Habanes/BFH_balancing_robot/documentation/balanceBot/hardware/RaspiGPIO_V12.xlsx

Pin | GPIO | Function | Pull |  | i2C Adress
1 |  | 3.3V |  | ADC: | 0x4B | 1001011
2 |  | 5V |  |  | 0x4D | 1001101
3 | GPIO 2 | I2C SDA | up
4 |  | 5V |  | oldIMU: | 0x53 | 1010011
5 | GPIO 3 | I2C SCL | up
6 |  | GND |  | newIMU: | 0x28 | 0101000
7 | GPIO 4 | NC | up
8 | GPIO 14 | NC | down
9 |  | GND
10 | GPIO 15 | NC | down
11 | GPIO 17 | M1_Other | down
12 | GPIO 18 | M2_Other | down
13 | GPIO 27 | NC | down
14 |  | GND
15 | GPIO 22 | NC | down
16 | GPIO 23 | M1_Dir | down
17 |  | 3.3V
18 | GPIO 24 | M2_Dir | down
19 | GPIO 10 | Encoder2_B | down
20 |  | GND
21 | GPIO 9 | Encoder2_A | down
22 | GPIO 25 | NC | down
23 | GPIO 11 | Encoder2_I | down
24 | GPIO 8 | Reset_IMU | up
25 |  | GND
26 | GPIO 7 | Int1 | up
27 | ID_SD | NC
28 | ID_SC | NC
29 | GPIO 5 | NC | up
30 |  | GND
31 | GPIO 6 | NC | up
32 | GPIO 12 | M2_PWM | down
33 | GPIO 13 | M1_PWM | down
34 |  | GND
35 | GPIO 19 | Encoder1_A | down
36 | GPIO 16 | NC | down
37 | GPIO 26 | NC | down
38 | GPIO 20 | Encoder1_B | down
39 |  | GND
40 | GPIO 21 | Encoder1_I | down
