Habanes/BFH_balancing_robot/documentation/balanceBot/hardware/BalanceRobotBOM_V12.xlsx

Comment | Description | Designator | Footprint | LibRef | Value | Quantity per board | price/1 | price total | ordering from | order nr | link
DRV8231ADDAR | Motor Drives 33V H bridge motor driver with current regulation and current sense feedback | B1, B3 | SOIC127P600X170-9M | DRV8231ADDAR |  | 2 | 0.8 | 1.6 | mouser | 595-DRV8231ADDAR | https://www.mouser.ch/ProductDetail/Texas-Instruments/DRV8231ADDAR?qs=Li%252BoUPsLEnsv4Ur6m37LNQ%3D%3D
MCP3021A3T-E_OT | Analog to Digital Converters - ADC 10-bit ADC I2C Single Channel | B2 | SOT95P280X145-5M | MCP3021A3T-E_OT |  | 1 | 1.22 | 1.22 | mouser | 579-MCP3021A3T-E/OT | https://www.mouser.ch/ProductDetail/Microchip-Technology/MCP3021A3T-E-OT?qs=uHi2%2FQoPa5Cra0xx31l%252Buw%3D%3D
MCP3021A3T-E_OT | ANDERE I2C ADRESSE!!!! | B4 |  |  |  | 1 | 1.22 | 1.22 | mouser | 579-MCP3021A5T-E/OT | https://www.mouser.ch/ProductDetail/Microchip-Technology-Atmel/MCP3021A5T-E-OT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
S-1011A70-M6T1U4 | Supervisory Circuits VOLTAGE DETECTOR | B5 | SOT95P275X135-6N | S-1011A70-M6T1U4 |  | 1 | 1.28 | 1.28 | mouser | 628-S-1011A70-M6T1U4 | https://www.mouser.ch/ProductDetail/ABLIC/S-1011A70-M6T1U4
AP1501-50K5G-13 | IC REG BUCK 5V 3A TO263-5 | B6 | AP150150K5G13 | AP1501-50K5G-13 |  | 1 | 1.6 | 1.6 | mouser | 621-AP1501-50K5G-13 | https://www.mouser.ch/ProductDetail/Diodes-Incorporated/AP1501-50K5G-13?qs=oUsD4qhOtFyyLLjAHWqfUw%3D%3D
LSF0204PW-Q100J | Translation - Voltage Levels ANALOG & LOGIC ICS | B8, B9 | SOP65P640X110-14M | LSF0204PW-Q100J |  | 2 | 0.7 | 1.4 | mouser | 771-LSF0204PW-Q100J | https://www.mouser.ch/ProductDetail/Nexperia/LSF0204PW-Q100J
74LCX157FT | 74LCX157FT Toshiba, Multiplexer Quad, -0.5 6.5 V, 16-Pin TSSOP | B10, B11 | SOP65P640X120-16M | 74LCX157FT |  | 2 | 0.34 | 0.68 | mouser | 757-74LCX157FT | https://www.mouser.ch/ProductDetail/Toshiba/74LCX157FT?qs=F5EMLAvA7IBvOqmQf3om6A%3D%3D
Cap Pol2 | Polarized Capacitor (Axial) | C1, C4 | CAP68uF | Cap Pol2 | 68uF | 2 | 0.26 | 0.52 | mouser | 667-EEU-FM1V680 | https://www.mouser.ch/ProductDetail/Panasonic/EEU-FM1V680?qs=iurMsj5%2FK0vhtj0IMGrPJw%3D%3D
Cap | Capacitor | C2, C3, C5, C6, C7, C10, C18, C19, C20, C21, C22, C25, C26, C28, C29 | 0805_Lorin | Cap | 100nF | 15 | 0.09 | 1.35 | mouser | 187-CL21B104KAFNNNE | https://www.mouser.ch/ProductDetail/Samsung-Electro-Mechanics/CL21B104KAFNNNE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
Cap | Capacitor | C8, C9 | 0805_Lorin | Cap | ~2.2uF | 2 | 0.34 | 0.68 | mouser | 187-CL21B225KAFVPJE | https://www.mouser.ch/ProductDetail/Samsung-Electro-Mechanics/CL21B225KAFVPJE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
Cap | Capacitor | C12 | 0805_Lorin | Cap | 40 - 80 nF | 1 | 0.09 | 0.09 | mouser | 187-CL21B473KBCNNNC | https://www.mouser.ch/ProductDetail/Samsung-Electro-Mechanics/CL21B473KBCNNNC?qs=349EhDEZ59p8vyw6Prguww%3D%3D
Cap Pol2 | Polarized Capacitor (Axial) | C13, C14 | CAP390uF | Cap Pol2 | ~390uF | 2 | 0.51 | 1.02 | mouser | 667-EEU-FR1V391L | https://www.mouser.ch/ProductDetail/Panasonic/EEU-FR1V391L?qs=Ao3mORb5HCCOkPrXwcqwAg%3D%3D
Cap Pol2 | Polarized Capacitor (Axial) | C15 | CAP220uF | Cap Pol2 | 220uF | 1 | 0.61 | 0.61 | mouser | 667-EEU-FS1H221LB | https://www.mouser.ch/ProductDetail/Panasonic/EEU-FS1H221LB
Cap | Capacitor | C16, C17, C27 | 0805_Lorin | Cap | 22uF | 3 | 0.28 | 0.84 | mouser | 187-CL21A226MAYNNWE | https://www.mouser.ch/ProductDetail/Samsung-Electro-Mechanics/CL21A226MAYNNWE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
Cap | Capacitor | C30 | 0805_Lorin | Cap | 1uF | 1 | 0.3 | 0.3 | mouser | 187-CL21B105KAFVPJE | https://www.mouser.ch/ProductDetail/Samsung-Electro-Mechanics/CL21B105KAFVPJE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
red LED 1V8 | Typical INFRARED GaAs LED | D1 | LEDC2012X75M | LED0 |  | 1 | 0.51 | 0.51 | mouser | 604-APT2012LSECKJ3RV | https://www.mouser.ch/ProductDetail/Kingbright/APT2012LSECK-J3-PRV?qs=6oMev5NRZMEkGJkKIsAalQ%3D%3D
B340A | Schottky Diode | D2 | SODFL5226X110M | D Schottky |  | 1 | 0.33 | 0.33 | mouser | 621-B340AF-13 | https://www.mouser.ch/ProductDetail/Diodes-Incorporated/B340AF-13?qs=lqAf%2FiVYw9huCbbmW2KJVg%3D%3D
green LED 2V65 | Typical INFRARED GaAs LED | D3 | LEDC2012X75M | LED0 |  | 1 | 0.48 | 0.48 | mouser | 604-APT2012LZGCK | https://www.mouser.ch/ProductDetail/Kingbright/APT2012LZGCK?qs=6oMev5NRZMHOosFiXb%2F3qw%3D%3D
Inductor | Inductor | L1 | Inductor | Inductor | 47uH | 1 | 0.83 | 0.83 | mouser | 667-ETQ-P4M470KFM | https://www.mouser.ch/ProductDetail/Panasonic/ETQ-P4M470KFM?qs=PqoDHHvF64%252BZFh2Y0Z5cng%3D%3D
BatteryConnector | Header, 3-Pin | P1 | BatteryConnector | Header 3 |  | 1 | 0.2 | 0.2 | distrelec | 143-01-995 | https://www.distrelec.ch/de/stiftleiste-einreihig-gerade-3p-header-stecker-positionen-5mm-jst-b3b-xh/p/14301995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
Motor1 | Header, 2-Pin | P2,P4 | MotorConnector | Header 2 |  | 2 | 0.18 | 0.36 | distrelec | 143-01-944 | https://www.distrelec.ch/de/stiftleiste-einreihig-gerade-2p-header-stecker-positionen-2mm-jst-b2b-ph/p/14301944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
RaspiConnector | Header, 20-Pin, Dual row | P3 | HDR2X20 | Header 20X2 |  | 1 | 2.5 | 2.5 | distrelec | 143-84-006 | https://www.distrelec.ch/de/803-gerade-buchse-leiterplattenbuchsenleiste-durchsteckmontage-reihen-20-kontakte-54mm-raster-preci-dip-803-87-020-10-001101/p/143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
Encoder1 | Header, 10-Pin | P5,P6 | EncoderConnector | Header 10 |  | 2 | 1.66 | 3.32 | mouser | 649-2002152100010E1L | https://www.mouser.ch/ProductDetail/Amphenol-FCI/20021521-00010E1LF?qs=F5OeB0fGKdjADcPZG8zTow%3D%3D
Res2 | Resistor | R1 | 0805_Lorin | Res2 | 390 | 1 | 0.23 | 0.23 | mouser | 667-ERJ-U6RD3900V | https://www.mouser.ch/ProductDetail/Panasonic/ERJ-U6RD3900V
Res2 | Resistor | R2, R4 | 0805_Lorin | Res2 | 680 | 2 | 0.32 | 0.64 | mouser | 667-ERJ-PB6B6800V | https://www.mouser.ch/ProductDetail/Panasonic/ERJ-PB6B6800V
Res2 | Resistor | R3 | 0805_Lorin | Res2 | 5K | 1 | 0.34 | 0.34 | mouser | 667-ERJ-HP6D4991V | https://www.mouser.ch/ProductDetail/Panasonic/ERJ-HP6D4991V
Res2 | Resistor | R5 | 0805_Lorin | Res2 | 620 | 1 | 0.17 | 0.17 | mouser | 667-ERJ-T06J621V | https://www.mouser.ch/ProductDetail/Panasonic/ERJ-T06J621V
Res2 | Resistor | R6 | 0805_Lorin | Res2 | 750 | 1 | 0.09 | 0.09 | mouser | 667-ERJ-6ENF7500V | https://www.mouser.ch/ProductDetail/Panasonic/ERJ-6ENF7500V?qs=sGAEpiMZZMvdGkrng054t8AJgcdMkx7xPOPdXVD18QA%3D
Res2 | Resistor | R7, R10, R11 | 0805_Lorin | Res2 | 10K | 3 | 0.11 | 0.33 | mouser | 667-ERJ-6GEYJ103V | https://www.mouser.ch/ProductDetail/Panasonic/ERJ-6GEYJ103V?qs=sGAEpiMZZMvdGkrng054t8ugkoYZivkgQLewF4XpR24%3D
Res2 | Resistor | R8, R9 | 0805_Lorin | Res2 | 2K | 2 | 0.09 | 0.18 | mouser | 667-ERJ-6GEYJ202V | https://www.mouser.ch/ProductDetail/Panasonic/ERJ-6GEYJ202V?qs=tQNqqtTOejIIQ7OKxiM92w%3D%3D
Switch |  | S1 | Switch | Switch |  | 1 | 3.2 | 3.2 | distrelec | 301-52-606 | https://www.distrelec.ch/en/miniature-slide-switch-1co-on-on-pcb-pins-rnd-components-rnd-210-00583/p/30152607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
BNO055 | No Description Available | U1 | QFN_BNO055_BOS | BNO055 |  | 1 | 10.66 | 10.66 | mouser | 262-BNO055 | https://www.mouser.ch/ProductDetail/Bosch-Sensortec/BNO055?qs=QhAb4EtQfbV8Z2YmISucWw%3D%3D
