Habanes/BFH_balancing_robot/(list of files, drawings)

Other design files:
documentation/balanceBot/hardware/PCB/BalanceRobot.PrjPcb
documentation/balanceBot/hardware/PCB/Encoder.SchDoc
documentation/balanceBot/hardware/PCB/MotorDrivers.SchDoc
documentation/balanceBot/hardware/PCB/Multiplexer.SchDoc
documentation/balanceBot/hardware/PCB/newIMU.SchDoc
documentation/balanceBot/hardware/PCB/old_IMU.SchDoc
documentation/balanceBot/hardware/PCB/PCB_V12.PcbDoc
documentation/balanceBot/hardware/PCB/PCBLib.PcbLib
documentation/balanceBot/hardware/PCB/PowerSupply.SchDoc
documentation/balanceBot/hardware/PCB/Schema.SchDoc
documentation/balanceBot/hardware/PCB/SchematicLib.SchLib
