Habanes/BFH_balancing_robot/(commit log)

2025-03-28 inital commit
    [BalanceRobot.PrjPcb, BalanceRobotBOM_V12.xlsx, Encoder.SchDoc, MotorDrivers.SchDoc, Multiplexer.SchDoc, PCBLib.PcbLib, PCB_V12.PcbDoc, PowerSupply.SchDoc]
2025-04-09 Reset main to match clean branch contents
    [hardwarePWMLib.py, imu.py, main.py, motorController.py, motorEncoder.py]
2025-06-09 Test, last time was broken
    [main.py]
2025-06-09 Last one worked but output sign wrong, now added encoder
    [main.py, motorEncoder.py]
2025-06-09 Diagnosic successful in last, now corrected accidentally commented out section
    [main.py]
2025-06-09 Last version was working somewhat, but unstable now, especially when moving controls
    [TEST_timing_analysis.py, main_optimized.py]
2025-06-09 No Encoder Timing Test
